rommeljose/Conversor-A-D/otros/fotos/Base_sd.JPG

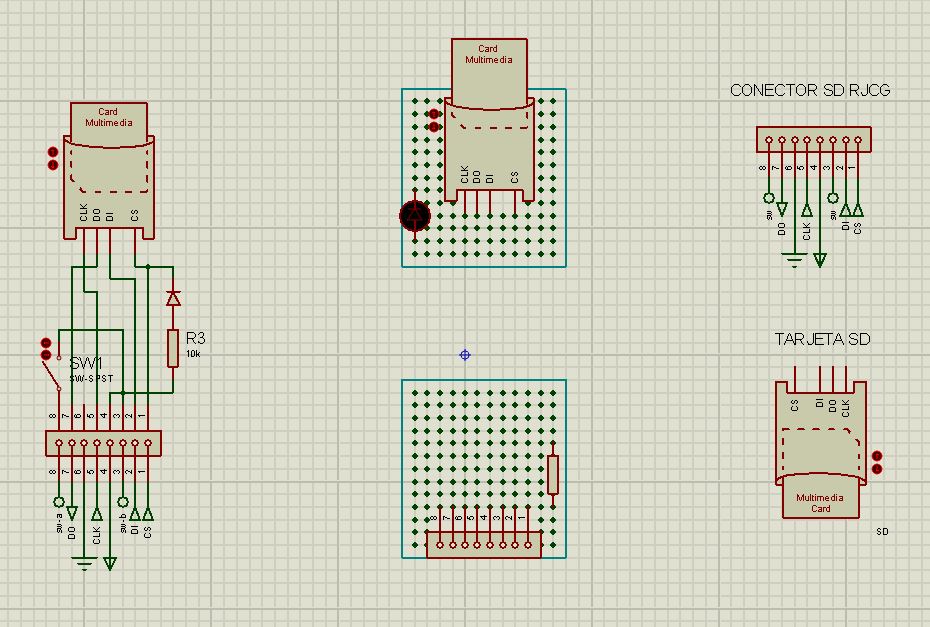
otros/fotos/Base_sd.JPG
