rommeljose/Conversor-A-D/otros/fotos/TARJETA_DESARROLLO.JPG

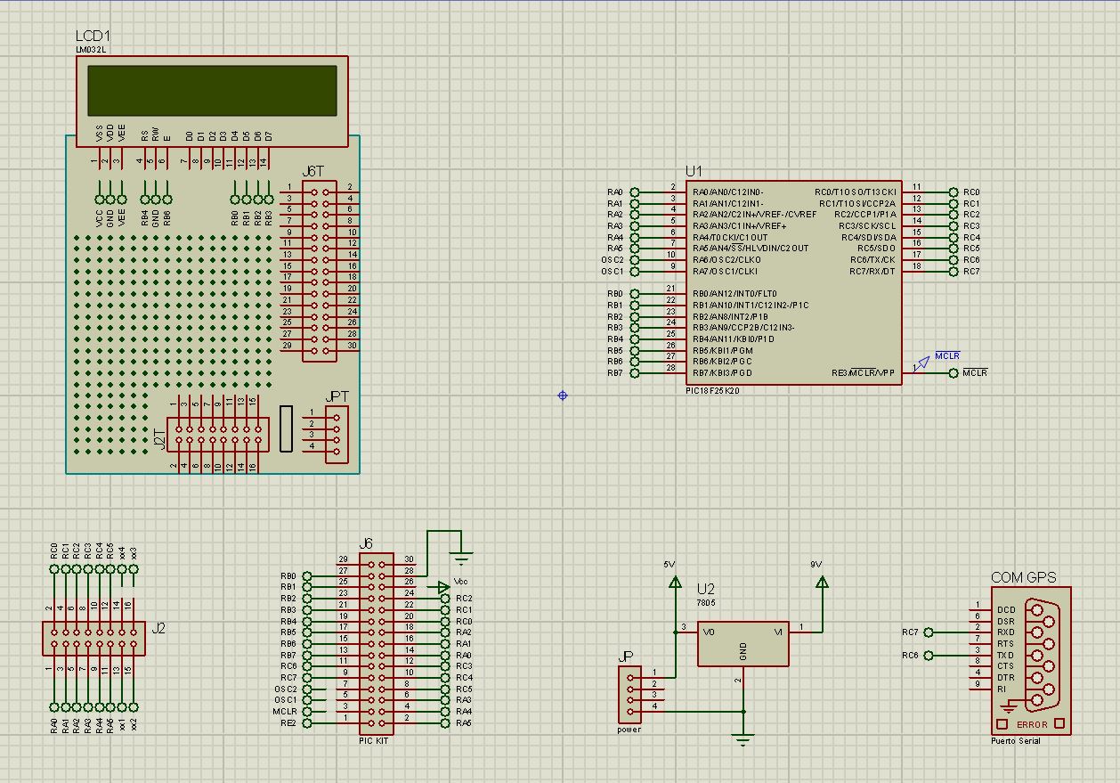
otros/fotos/TARJETA_DESARROLLO.JPG
