rommeljose/Conversor-A-D/otros/fotos/voltajeS_referenciaS.jpg

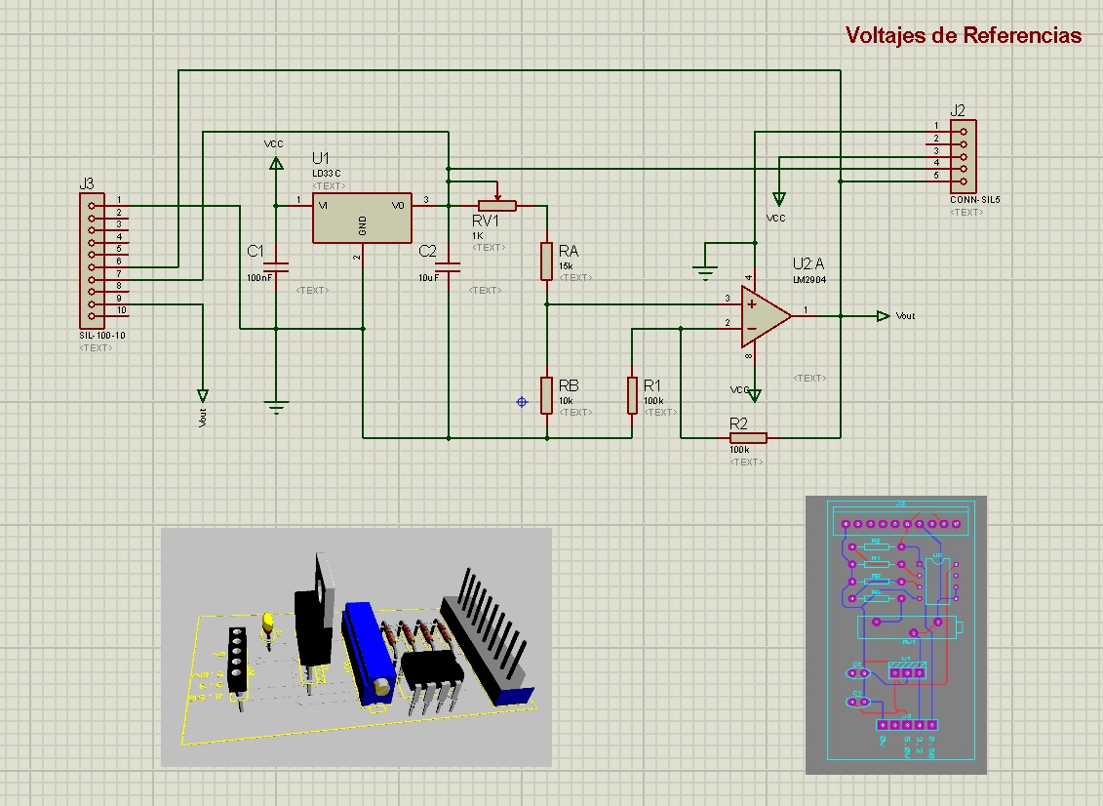
otros/fotos/voltajeS_referenciaS.jpg
