rommeljose/Conversor-A-D/(list of files, drawings)

Other design files:
otros/DGN/amplificador_geofono.DSN
otros/DGN/PIC25K20+LCD+SERIAL.pdsprj
otros/DGN/Tarjeta_desarrollo_RJCG.DSN
otros/DGN/Vol_ref.DSN
