rommeljose/Conversor-A-D/Lib_mias_all/Librerias_microchip/delay_xlcd.c

/**********************************************************************
* 2009 Microchip Technology Inc.
*
* FileName:        	delay_xlcd.c
* Dependencies:    Header (.h) files if applicable, see below
* Processor:       	PIC18F
* Compiler:        	MCC18 v3.30 or higher
*
* SOFTWARE LICENSE AGREEMENT:
* Microchip Technology Incorporated ("Microchip") retains all 
* ownership and intellectual property rights in the code accompanying
* this message and in all derivatives hereto.  You may use this code,
* and any derivatives created by any person or entity by or on your 
* behalf, exclusively with Microchip's proprietary products.  Your 
* acceptance and/or use of this code constitutes agreement to the 
* terms and conditions of this notice.
*
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
* YOU ACKNOWLEDGE AND AGREE THAT, IN NO EVENT, SHALL MICROCHIP BE 
* LIABLE, WHETHER IN CONTRACT, WARRANTY, TORT (INCLUDING NEGLIGENCE OR
* BREACH OF STATUTORY DUTY), STRICT LIABILITY, INDEMNITY, 
* CONTRIBUTION, OR OTHERWISE, FOR ANY INDIRECT, SPECIAL, PUNITIVE, 
* EXEMPLARY, INCIDENTAL OR CONSEQUENTIAL LOSS, DAMAGE, FOR COST OR 
* EXPENSE OF ANY KIND WHATSOEVER RELATED TO THE CODE, HOWSOEVER 
* CAUSED, EVEN IF MICROCHIP HAS BEEN ADVISED OF THE POSSIBILITY OR THE
* DAMAGES ARE FORESEEABLE.  TO THE FULLEST EXTENT ALLOWABLE BY LAW, 
* MICROCHIP'S TOTAL LIABILITY ON ALL CLAIMS IN ANY WAY RELATED TO THIS
* CODE, SHALL NOT EXCEED THE PRICE YOU PAID DIRECTLY TO MICROCHIP 
* SPECIFICALLY TO HAVE THIS CODE DEVELOPED.
*
* You agree that you are solely responsible for testing the code and 
* determining its suitability.  Microchip has no obligation to modify,
* test, certify, or support the code.
*
* REVISION HISTORY:
*~~~~~~~~~~~~~~~~~~~~~~~~~~~~~~~~~~~~~~~~~~~~~~~~~~~~~~~~~~~~~~~~~~~~~
* Author        	Date      	Comments on this revision
*~~~~~~~~~~~~~~~~~~~~~~~~~~~~~~~~~~~~~~~~~~~~~~~~~~~~~~~~~~~~~~~~~~~~~
* Harsha.J.M	04/04/09	First release of source file
*~~~~~~~~~~~~~~~~~~~~~~~~~~~~~~~~~~~~~~~~~~~~~~~~~~~~~~~~~~~~~~~~~~~~~
  *          - The user must provide three delay routines:
 *              - DelayFor18TCY() provides a 18 Tcy delay
 *              - DelayPORXLCD() provides at least 15ms delay
 *              - DelayXLCD() provides at least 5ms delay
 */

#include <p18cxxx.h>
#include "../../mcc_generated_files/device_config.h"
#include "./xlcd.h"


/************************** Control del LCD *********************************/
//Conjunto de tiempos de demora para el control del Display LCD. Ok (2x16)

// DelayFor18TCY() provides a 18 Tcy delay
void DelayFor18TCY( void )
    {
    __delay_us(5);     // delay for 18 cycles
    //DELAY_microseconds(40);
        }

// DelayPORXLCD() provides at least 15ms delay
void DelayPORXLCD (void){
    __delay_ms(15);
    return;
    }

// DelayXLCD() provides at least 5ms delay
void DelayXLCD (void){
    __delay_ms(5);
    return;
}
