rommeljose/Conversor-A-D/(commit log)

2021-01-23 Conversor A/D 01
    [PIC25K20+LCD+SERIAL.pdsprj, Tarjeta_desarrollo_RJCG.DSN, Vol_ref.DSN, amplificador_geofono.DSN]
2021-01-23 Update README.md
    Archivos necesarios para replicar el programa Conversor Análogo/Digital elaborado en lenguaje C: MPLAB XC8 .
